Voidheart88/ELS-linreg/Ausarbeitung/els-ausarbeitung.tex

\input{preambel}
\input{environments}

\begin{document}
  \selectlanguage{ngerman}
  \input{kapitel/titelseite}
  \input{kapitel/abstract}
  \tableofcontents
  \input{kapitel/einfuehrung}     % Einleitung
  \input{kapitel/entwicklung}     % Entwicklung der Schaltung
  \input{kapitel/ergebnisse}      % Ergebnisse
  \newpage
  \addcontentsline{toc}{chapter}{Quellen}
  \bibliography{literatur}
  \addcontentsline{toc}{chapter}{Abbildungen}  
  \listoffigures
\end{document}
