Voidheart88/ELS-linreg/Ausarbeitung/preambel.tex

\documentclass[paper=A4,fontsize=12pt,headings=small,headsepline=true,footsepline=false,bibliography=totoc,DIV=7]{report}
\usepackage[utf8]{inputenc}
\usepackage[ngerman,english]{babel}
\usepackage{graphicx}
\usepackage{enumerate}
\usepackage{tabularx}
\usepackage{fancyhdr}
\usepackage{cite}
\usepackage{blindtext}
\usepackage[colorlinks,pdfpagelabels,pdfstartview = FitH,bookmarksopen = true,bookmarksnumbered = true,linkcolor = black,plainpages = false,hypertexnames = false,citecolor = black]{hyperref}
\usepackage{todonotes}
\usepackage{listings}
\usepackage{geometry}
\usepackage{wrapfig}
\usepackage{siunitx}
\usepackage{booktabs}

\clubpenalty=10000         % Keine "Schusterjungen"
\widowpenalty=10000        % Keine "Hurenkinder"
\displaywidowpenalty=10000 % Keine "Hurenkinder"
% Autor
\author{Dominik Stolte}
\title{\textbf{Seminararbeit \textendash{} Elektronische Schaltungen}}
\bibliographystyle{alphadin}
\geometry{left=3.0cm,right=2.5cm,top=2.5cm,bottom=2.5cm,includeheadfoot}
\setlength\abovecaptionskip{10pt}
