Voidheart88/ELS-linreg/Ausarbeitung/kapitel/titelseite.tex

\begin{titlepage}

  \par\vspace{1cm}
  \centering
	{\scshape\LARGE Hochschule Mannheim \par}
	\vspace{1cm}
	{\scshape\Large Seminararbeit ELS\par}
	\vspace{1.5cm}
	{\huge\bfseries Entwicklung eines rauscharmen diskreten linearreglers\par}
	\vspace{2cm}
	{\Large Erstellt von:\\
	Dominik Stolte, Mat. Nr.: 2150764, NM\\ 
	Dennis Henky Mat. Nr.: 2150765, NM\par}
	\vfill
	betreut durch\par
	Prof. \textsc{Koca}
	\vfill
	% Bottom of the page
	{\large \today\par}
\end{titlepage}
