Voidheart88/ELS-linreg/Ausarbeitung/kapitel/ergebnisse.tex

\chapter{Ergebnisse} 
Dieses Kapitel beschreibt die Ergebnisse der Arbeit.
Die bestückte Schaltung wird verschidenen Messungen unterzogen und diese 
ausgewertet.
Es wird auf Probleme bei der Inbetriebnahme hingewiesen und diese analysiert.
Zuletzt wird ein Fazit gezogen und auf zukünftige Möglichkeiten der Entwicklung
hingewiesen.

\section{Messungen}
Der folgende Abschnitt beschreibt die Messungen am Ausgang der fertigen 
Schaltung.
Es wurden verschiedene Messungen an der fertigen Schaltung durchgeführt.

\section{Probleme bei der Inbetriebnahme}
Bei der Inbetriebnahme wurde festgestellt, dass die Ausgangsspannung bei 
Einer Eingangsspannung über \num{19,4}\,\si{\volt} nicht mehr gehalten wird.
Dies entspricht nicht der Simulation. Auf die Gründe hierfür soll im folgenden
eingegangen werden.

\section{Fazit und Zukunft}
