Voidheart88/ELS-linreg/Ausarbeitung/kapitel/abstract.tex

\clearpage
\selectlanguage{ngerman}
\begin{abstract}
\noindent
Die Verfügbarkeit von Signalquellen mit hoher spektraler Reinheit ist für
die Entwicklung und der Bestimmung der Eigenschaften von 
Analog-Digital-Wandlern von besonderer Bedeutung.
Diese Arbeit beschreibt die Entwicklung, den Aufbau sowie den Test eines 
linearen Spannungsreglers zur Versorgung eines Wien-Robinson-Oszillators.
\end{abstract}
\selectlanguage{english}
\begin{abstract}
\noindent  
This could be your abstract.
\end{abstract}
\selectlanguage{ngerman}
