Voidheart88/ELS-linreg/common/messungen/in_vs_out.pdf

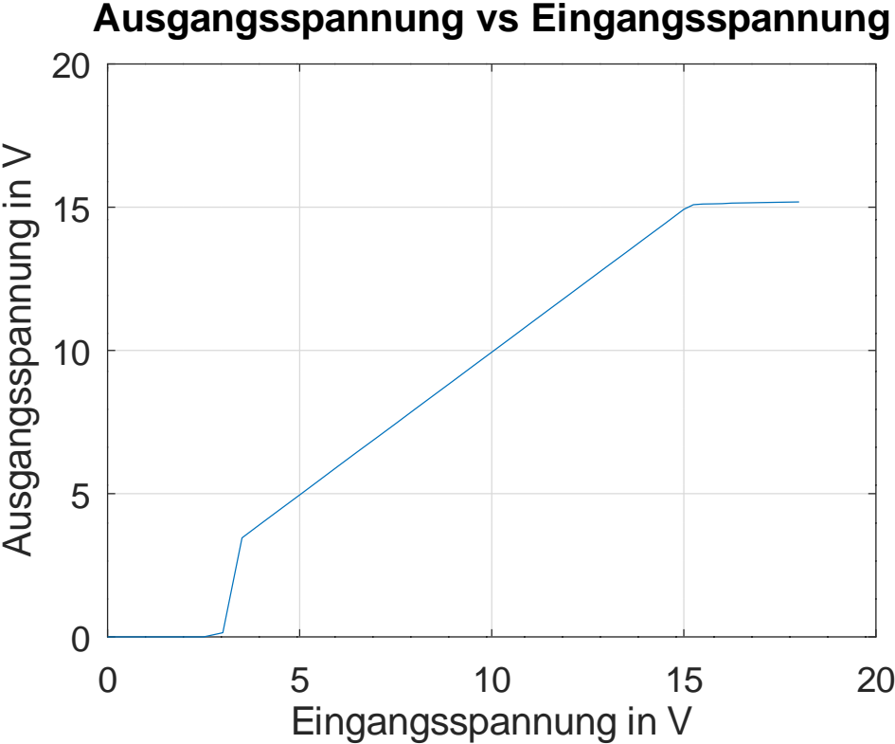
[picture p1: figure]
Eingangsspannung in V; Ausgangsspannung in V; Ausgangsspannung vs Eingangsspannung
