Voidheart88/ELS-linreg/common/Simulation/rauschen/haeufigkeit.pdf

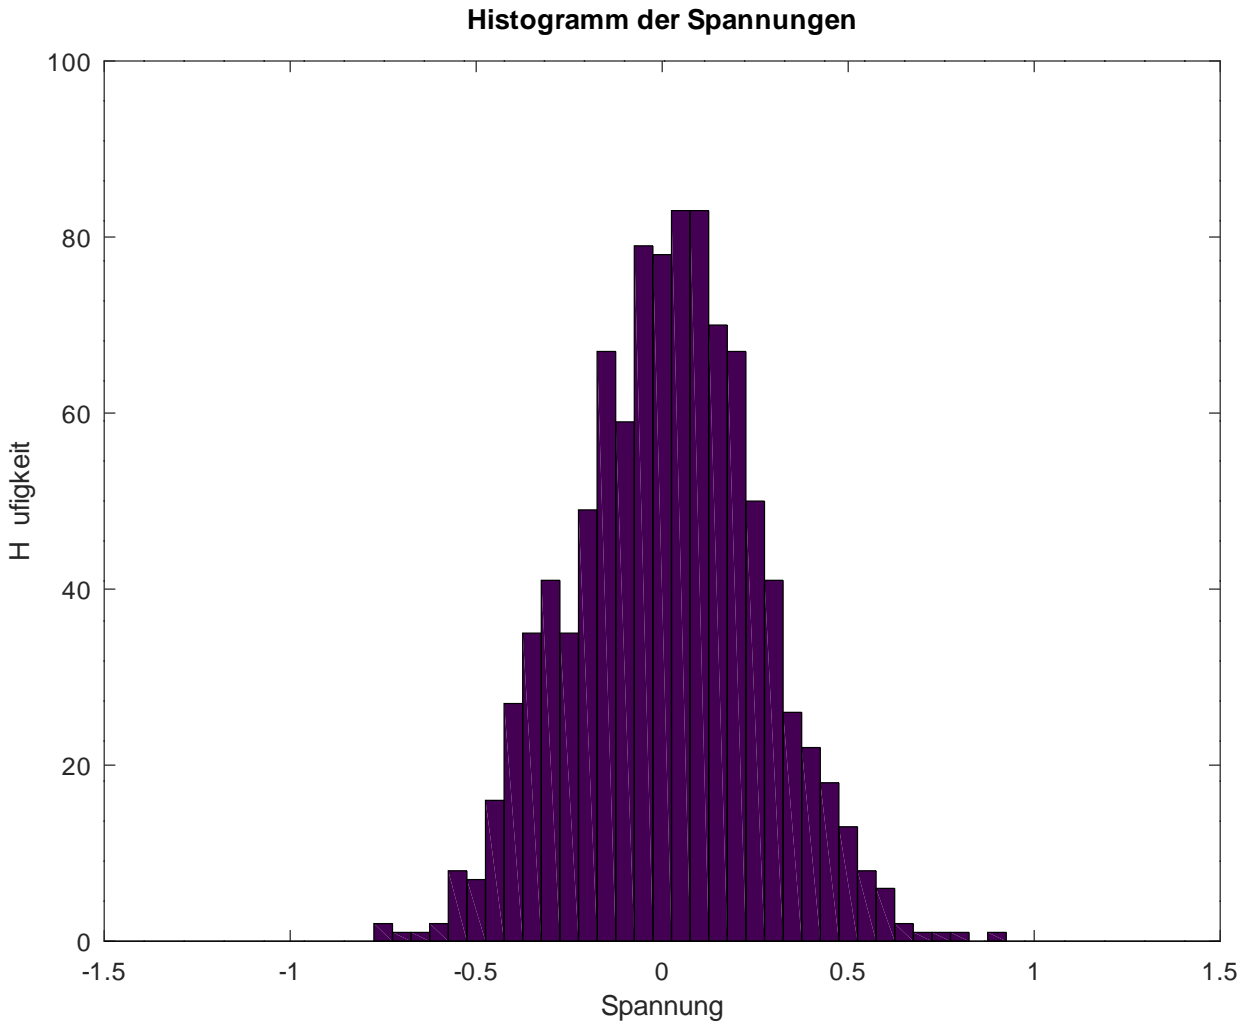
[picture p2: figure]
Histogramm der Spannungen; H ufigkeit; Spannung
