Voidheart88/ELS-linreg/common/Simulation/diagramme/0-25_R8.png

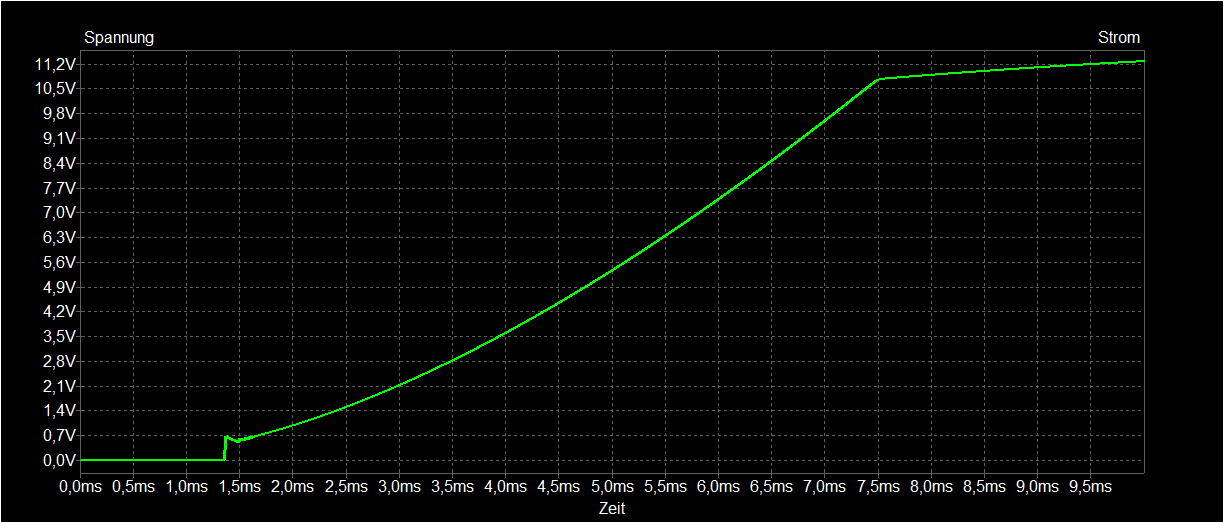
common/Simulation/diagramme/0-25_R8.png
