Voidheart88/ELS-linreg/common/Simulation/diagramme/10-25_eingangssignal.png

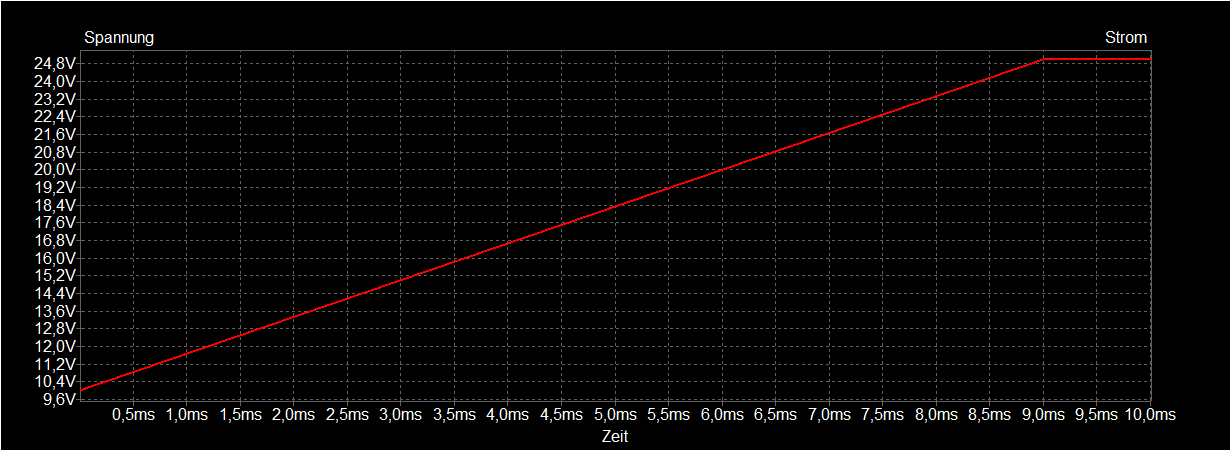
common/Simulation/diagramme/10-25_eingangssignal.png
