Voidheart88/ELS-linreg/common/Simulation/diagramme/10-25_eingangssignal_R8.png

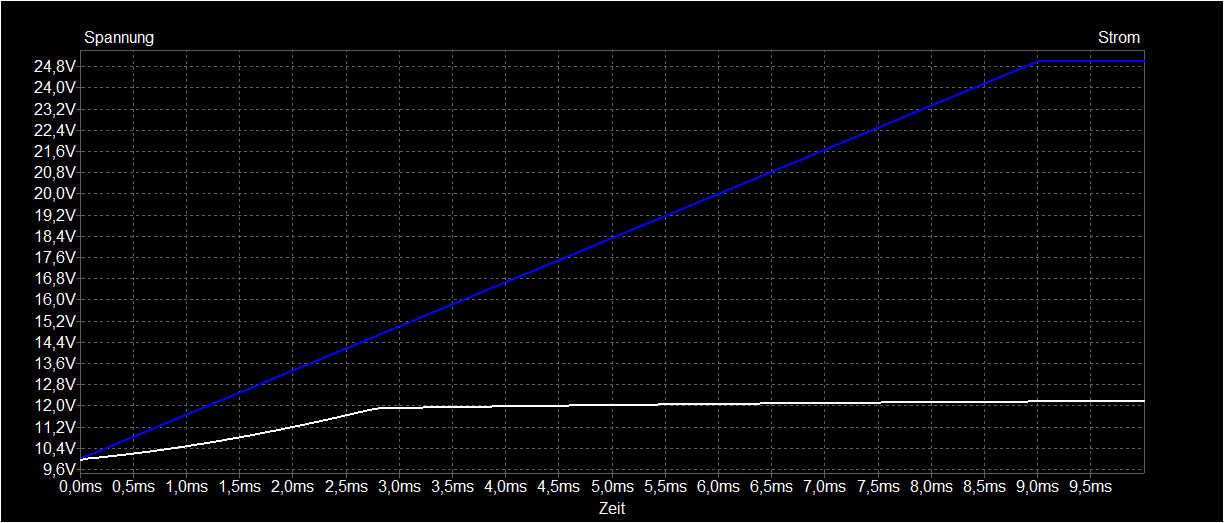
common/Simulation/diagramme/10-25_eingangssignal_R8.png
