Voidheart88/ELS-linreg/common/Simulation/out.pdf

5k 15V

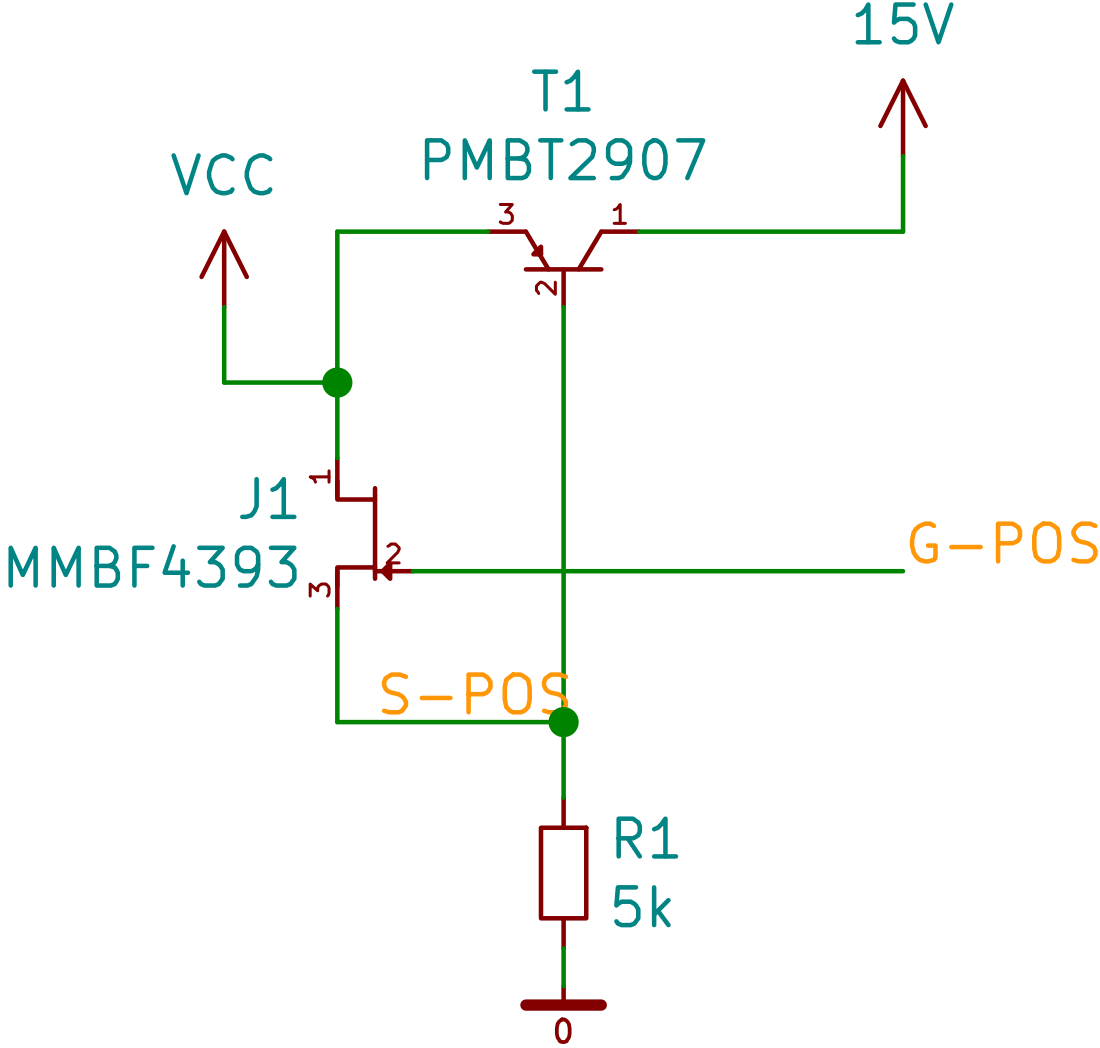
[picture p7: page 1]
VCC; 3 J1 MMBF4393; 3 T1 PMBT2907 S-POS; G-POS
