Voidheart88/ELS-linreg/common/Simulation/diffamp.pdf

# 5k VCC

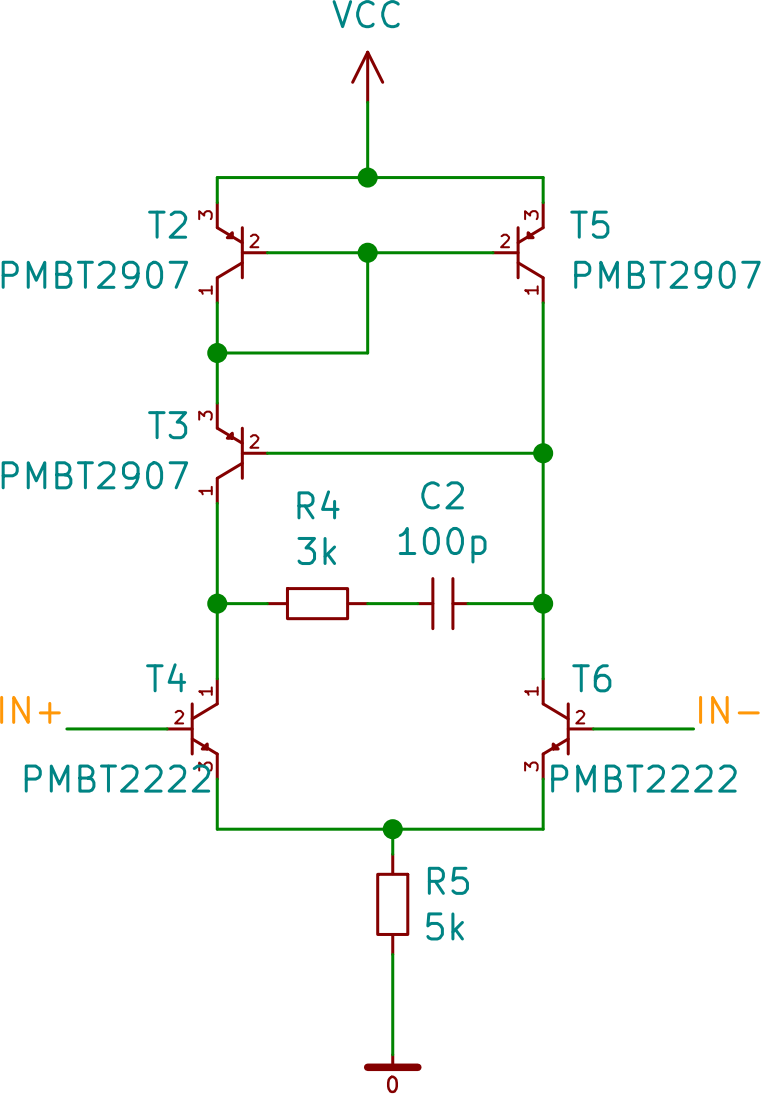
[picture p8: page 1]
3 T4 PMBT2222 R5; 3 T2 PMBT2907 1 2; 3 T5PMBT2907; 3 T6 PMBT2222; 3 T3 PMBT2907
