Voidheart88/ELS-linreg/common/Simulation/feedbackteiler.pdf

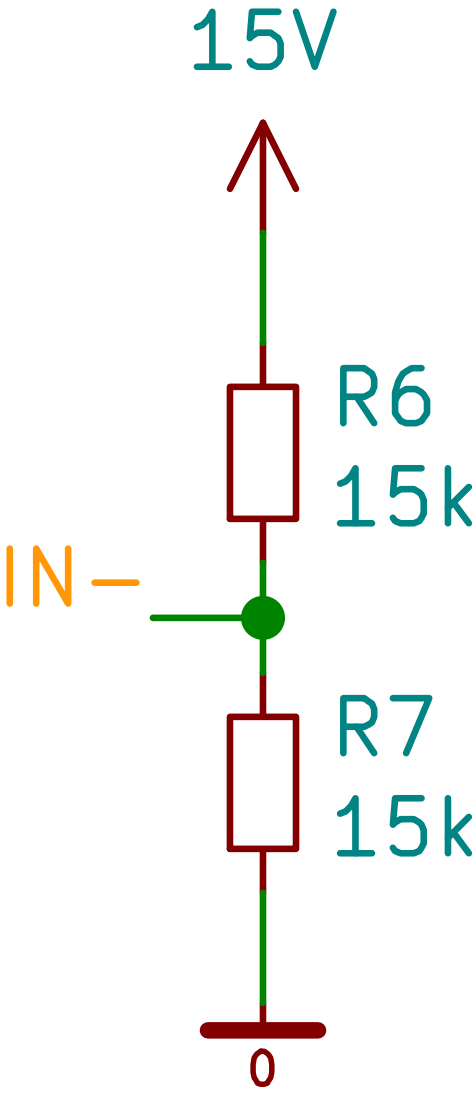
[picture p9: page 1]
