Voidheart88/ELS-linreg/common/Simulation/ref.pdf

# 1u VCC

1k R2

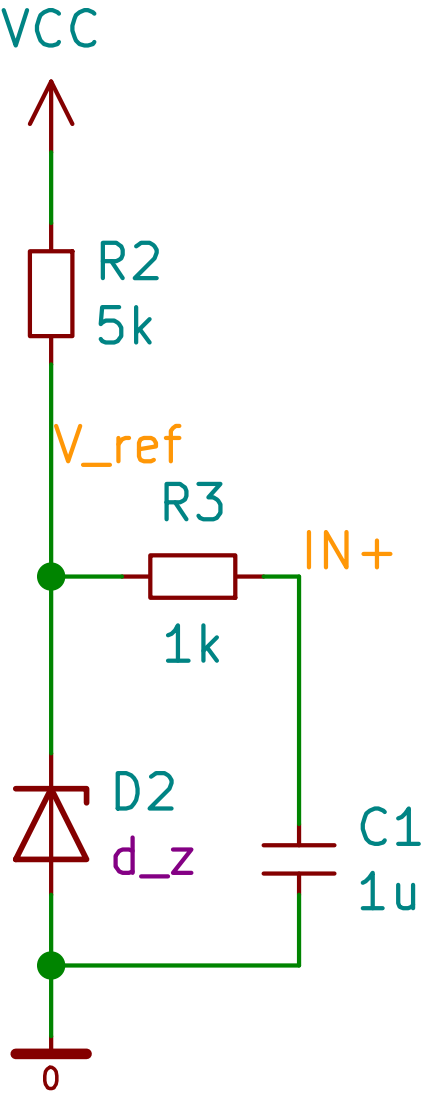
[picture p10: page 1]
5k V_ref
