Voidheart88/ELS-linreg/common/messungen/netzteilspannung.pdf

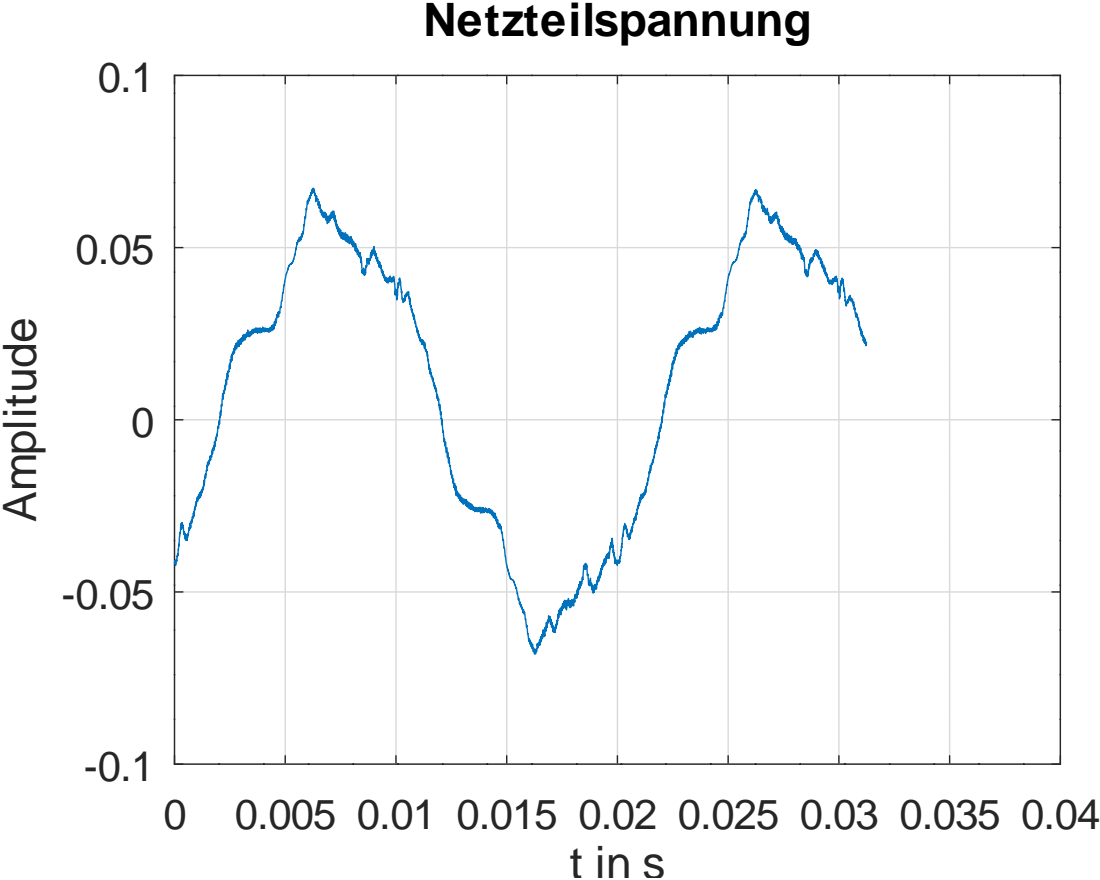
[picture p11: page 1]
Amplitude; Netzteilspannung
