Voidheart88/ELS-linreg/common/messungen/netzteilspektrum.pdf

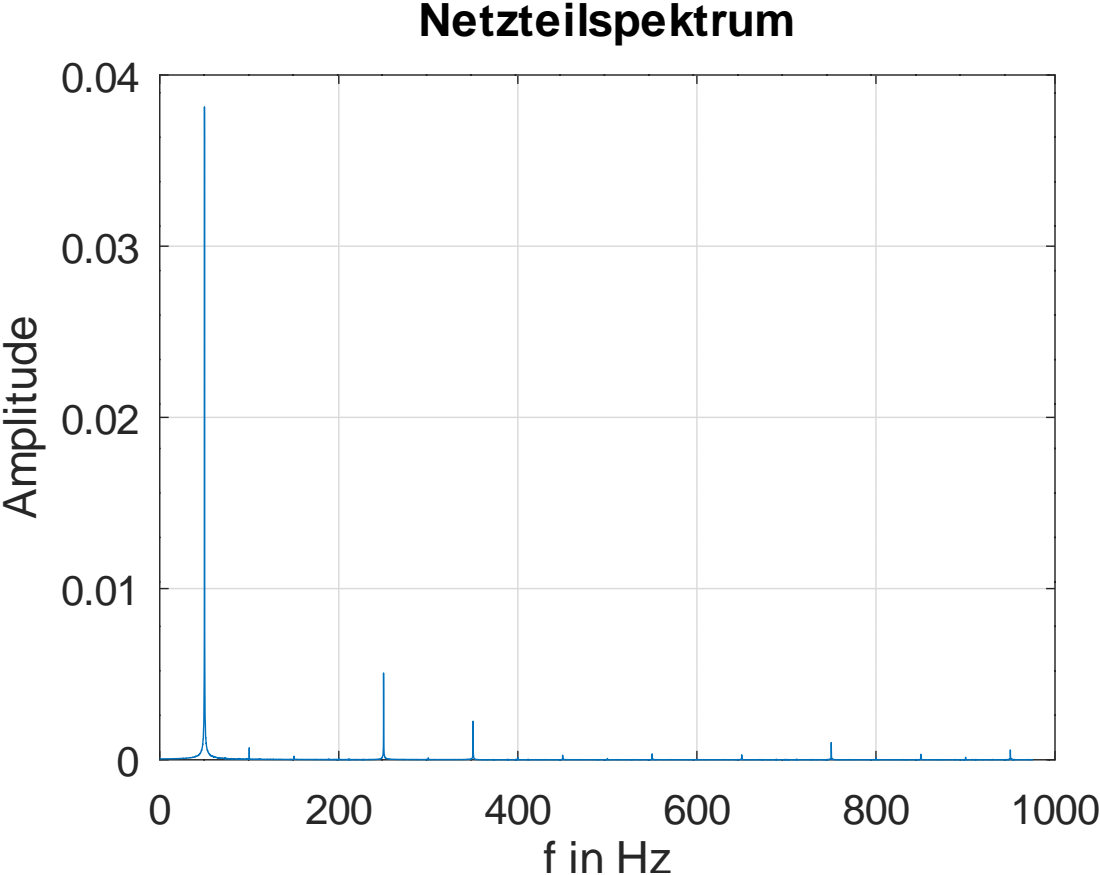
[picture p12: page 1]
Amplitude; Netzteilspektrum
