Voidheart88/ELS-linreg/common/messungen/regler-spg-batt.pdf

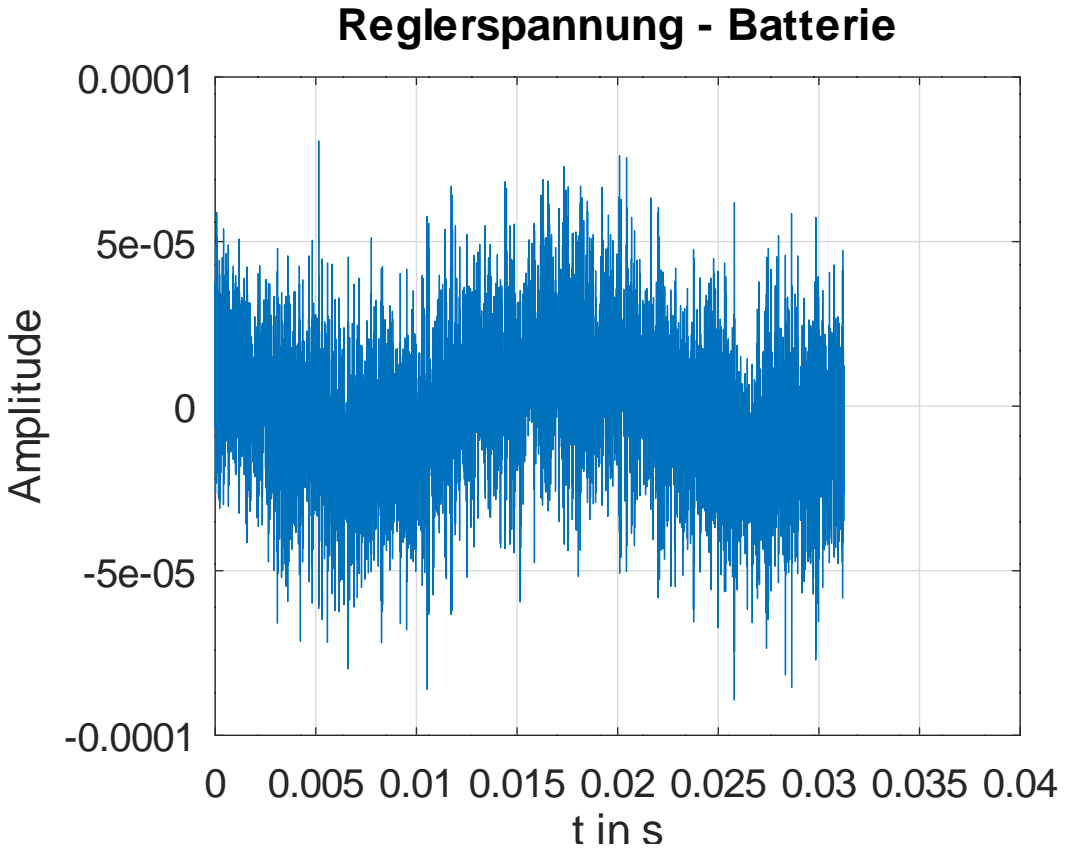
[picture p13: page 1]
Reglerspannung - Batterie; Amplitude
