Voidheart88/ELS-linreg/common/messungen/regler-spkt-batt.pdf

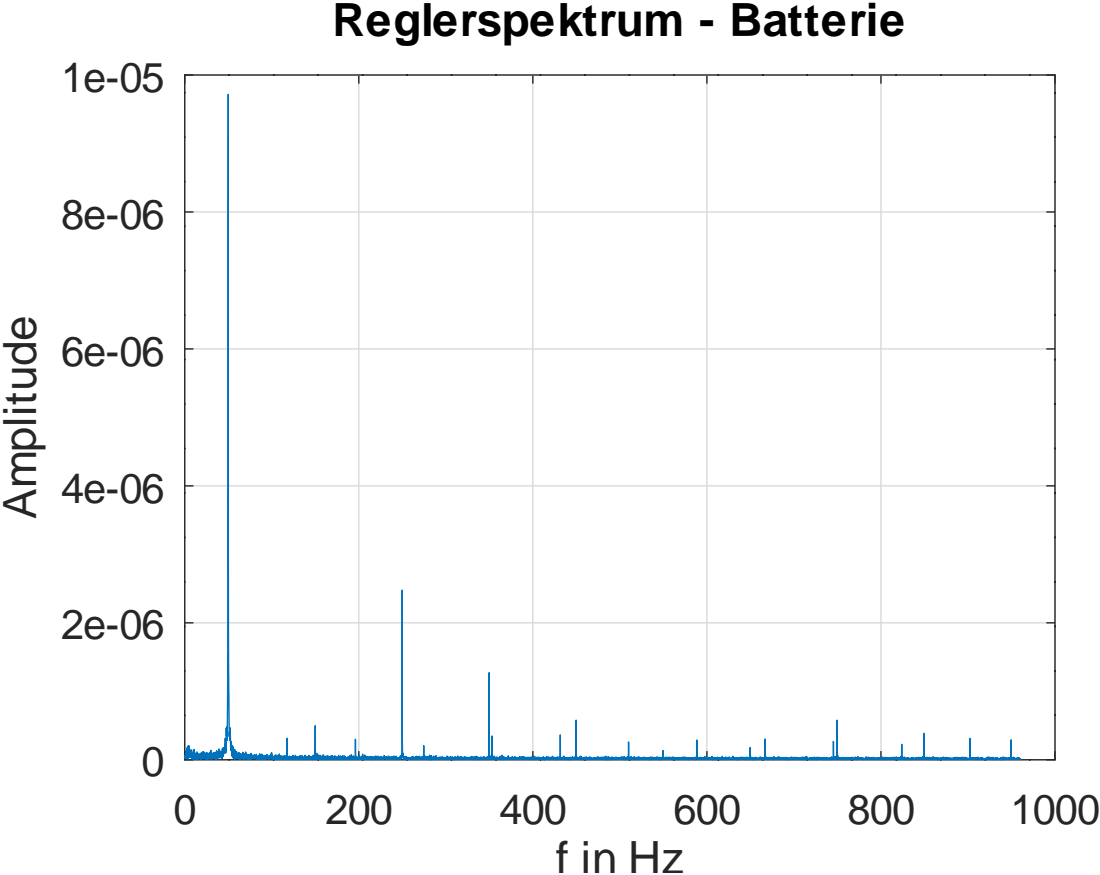
[picture p14: page 1]
Reglerspektrum - Batterie; Amplitude
