Voidheart88/ELS-linreg/common/messungen/reglerspannung.pdf

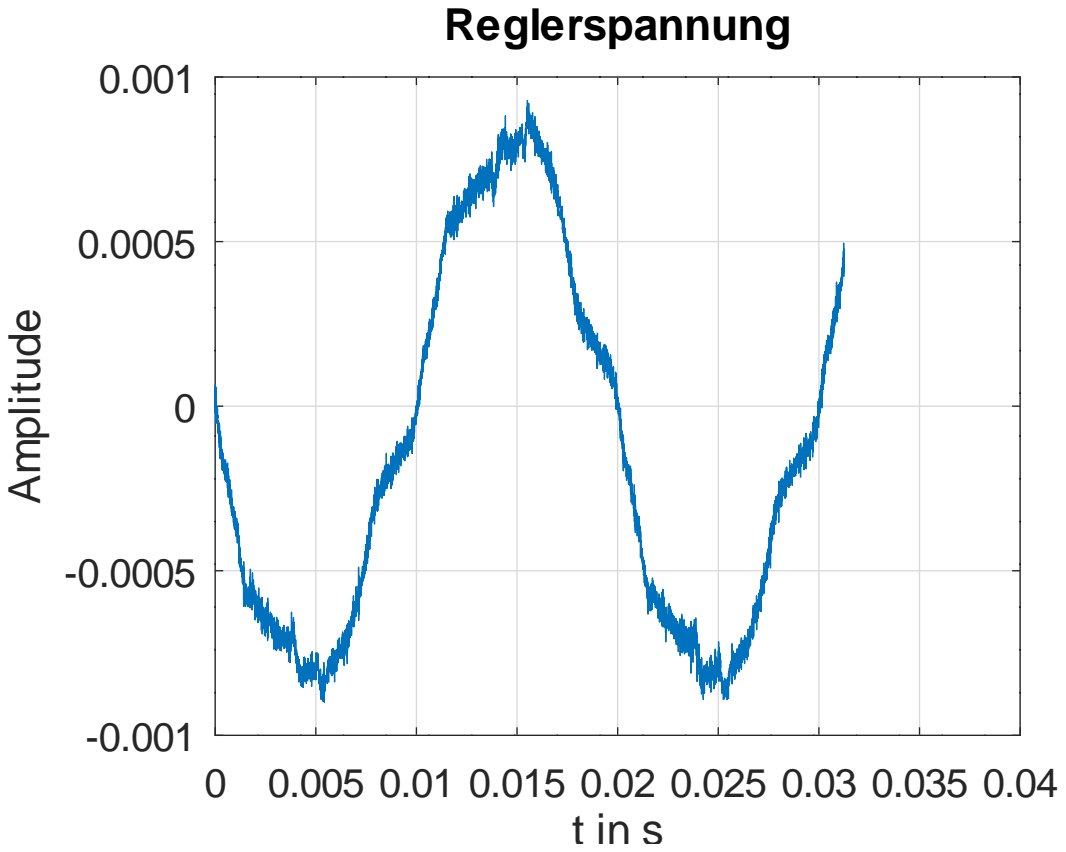
[picture p15: page 1]
Reglerspannung; Amplitude
