Voidheart88/ELS-linreg/common/messungen/reglerspektrum.pdf

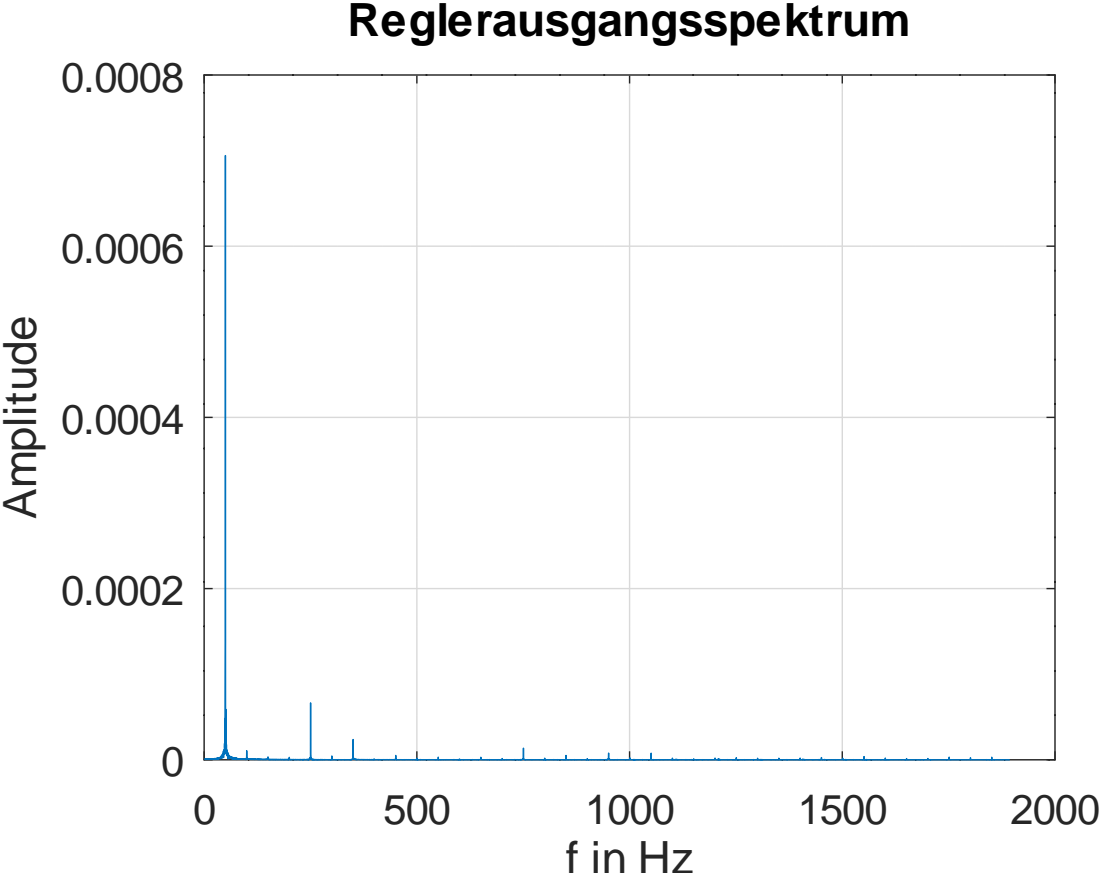
[picture p16: page 1]
Reglerausgangsspektrum; Amplitude
