Voidheart88/ELS-linreg/common/bilder/pcb-wien.pdf

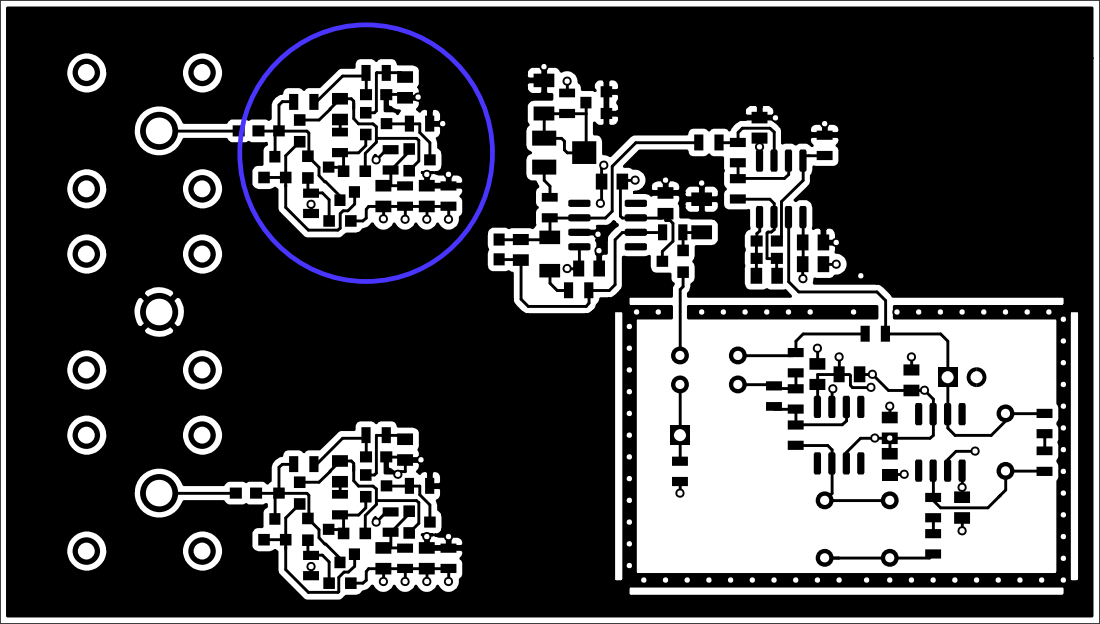
[picture p17: page 1]
