Voidheart88/ELS-linreg/common/bilder/schrotrauschen.pdf

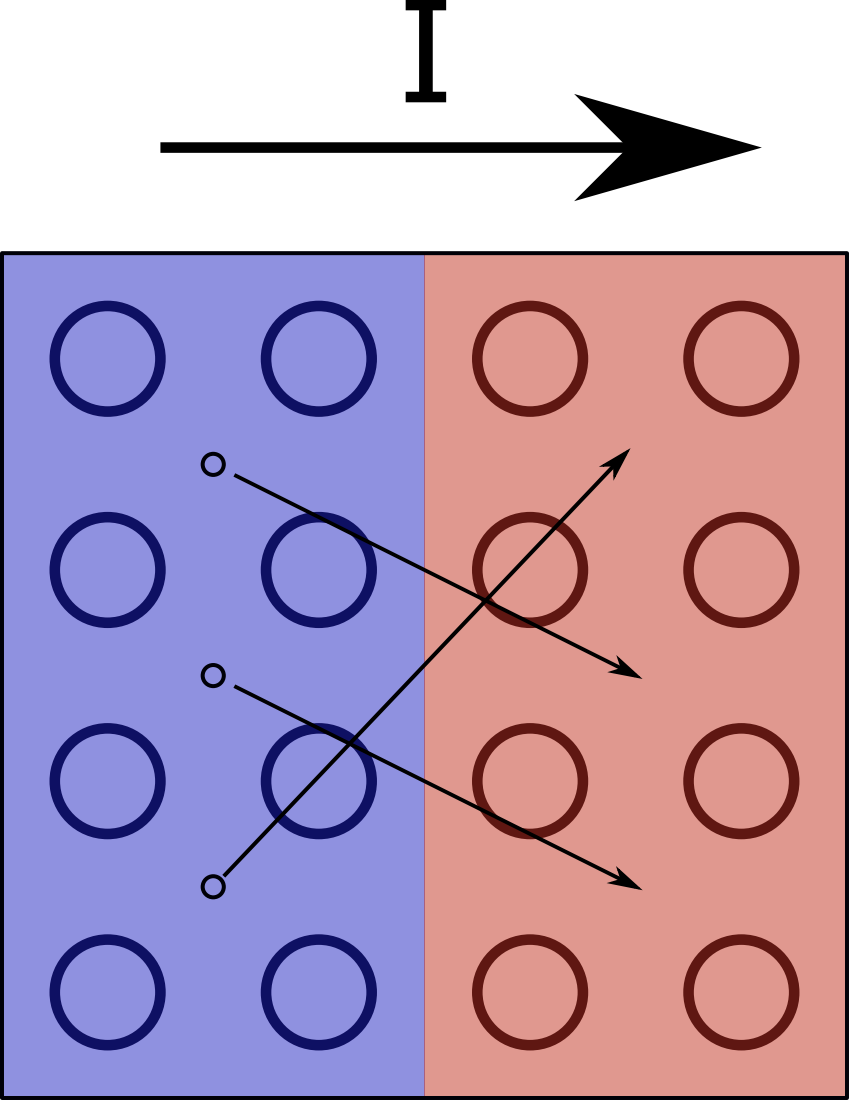
[picture p18: page 1]
