Voidheart88/ELS-linreg/common/schaltungen/reg.pdf

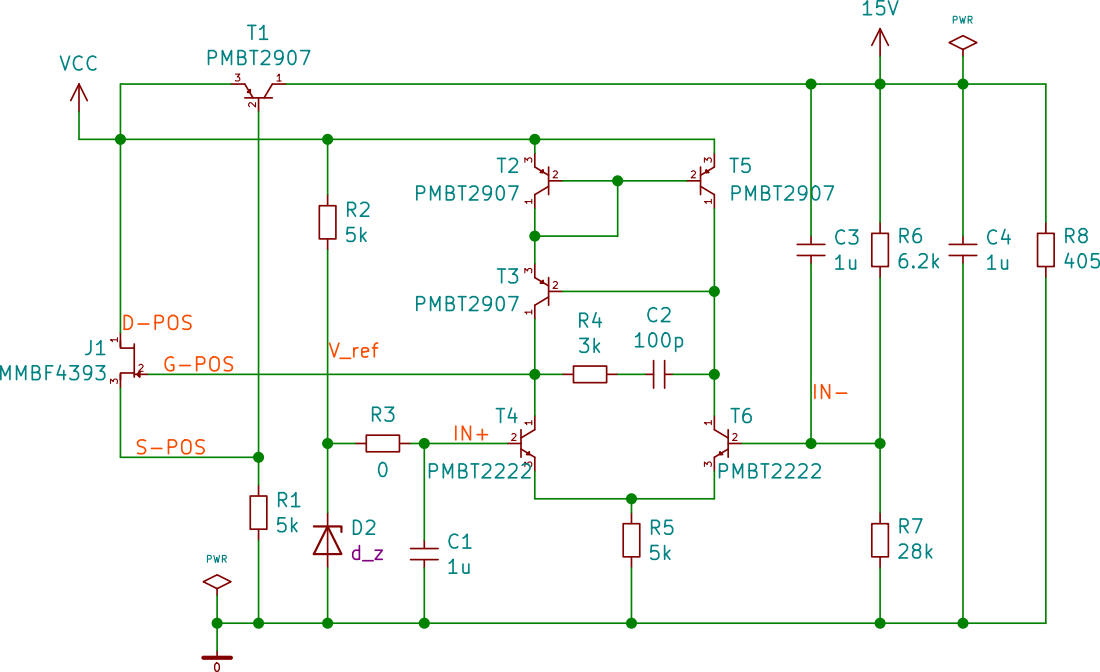
[picture p19: page 1]
