Voidheart88/ELS-linreg/common/schaltungen/last.pdf

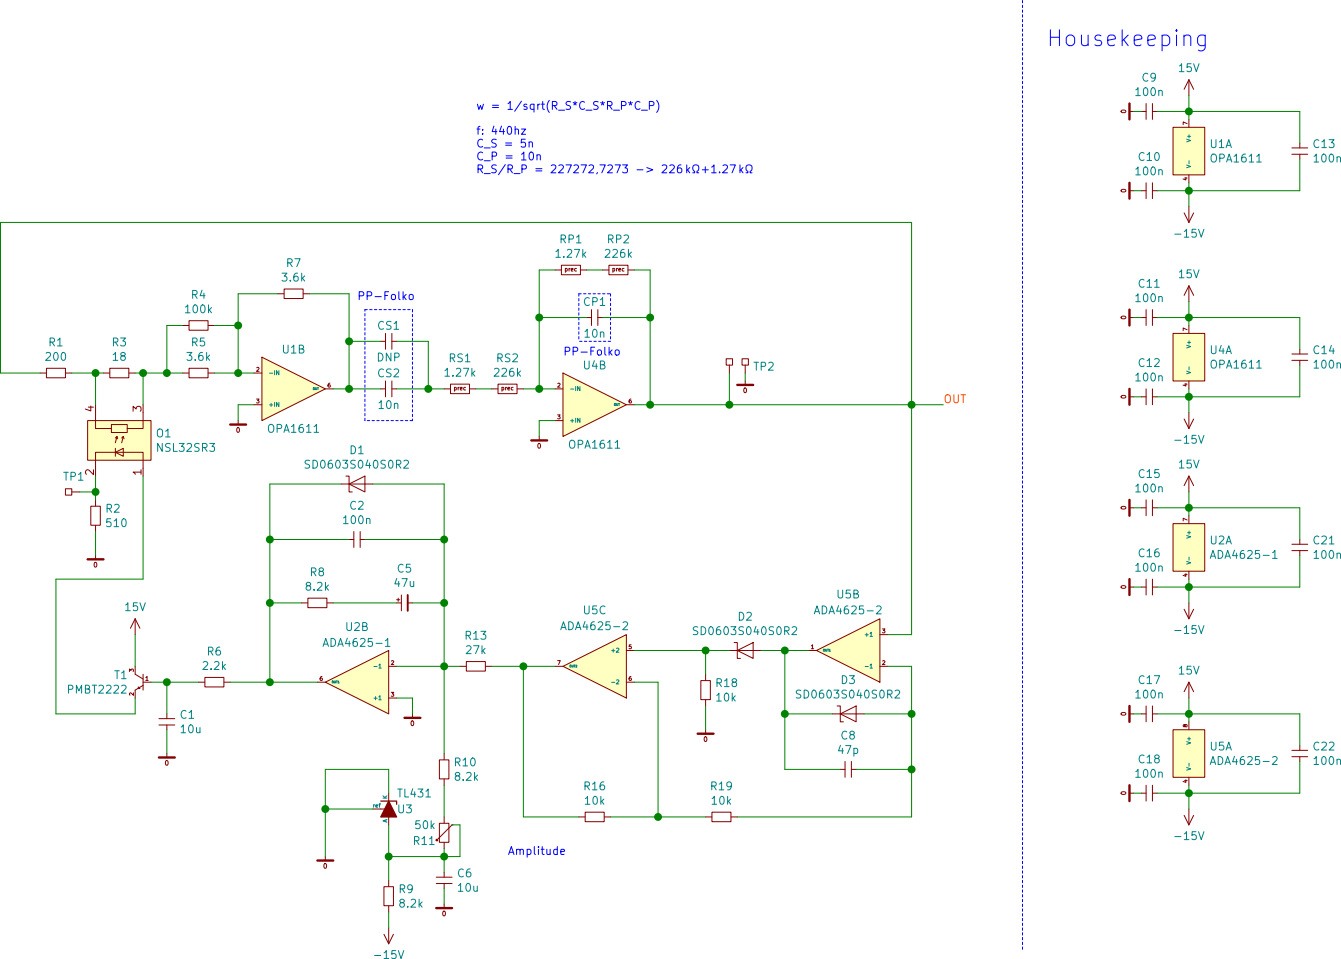
[picture p20: page 1]
