Voidheart88/ELS-linreg/common/Simulation/audioinput/pink-spkt.pdf

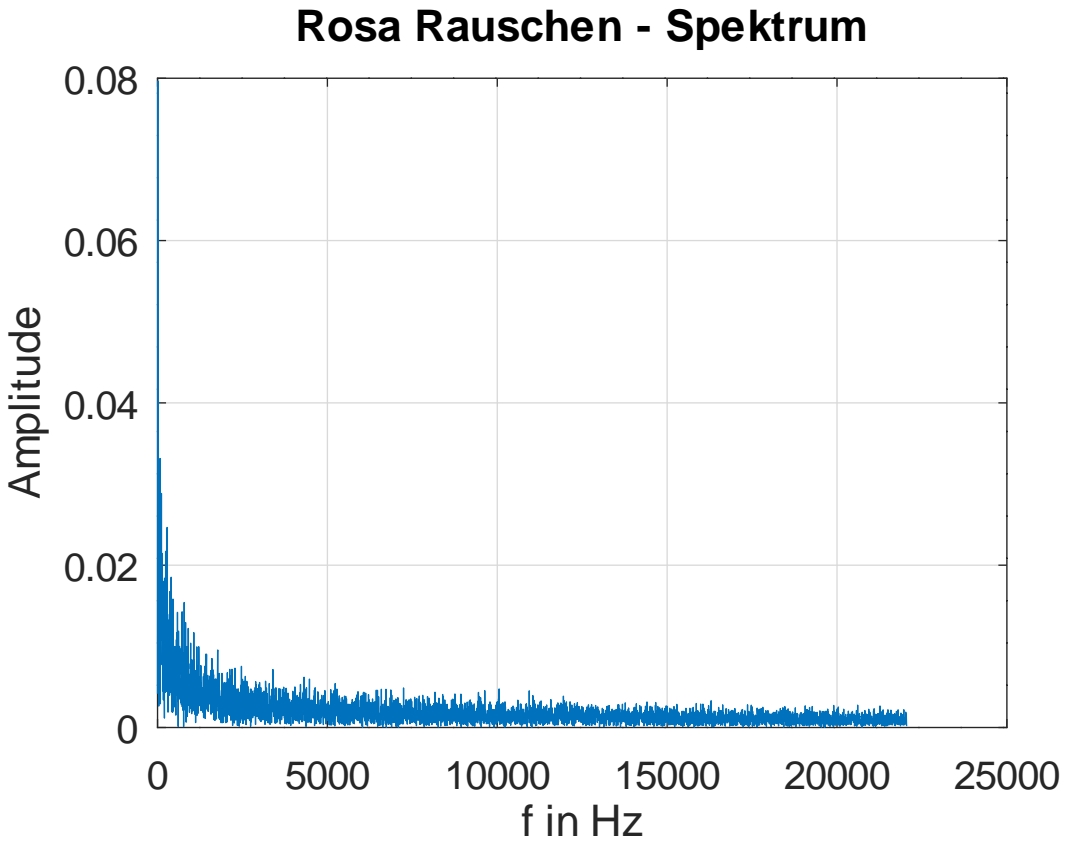
[picture p21: page 1]
Amplitude

Rosa Rauschen - Spektrum
