Voidheart88/ELS-linreg/common/Simulation/audioinput/pink-time.pdf

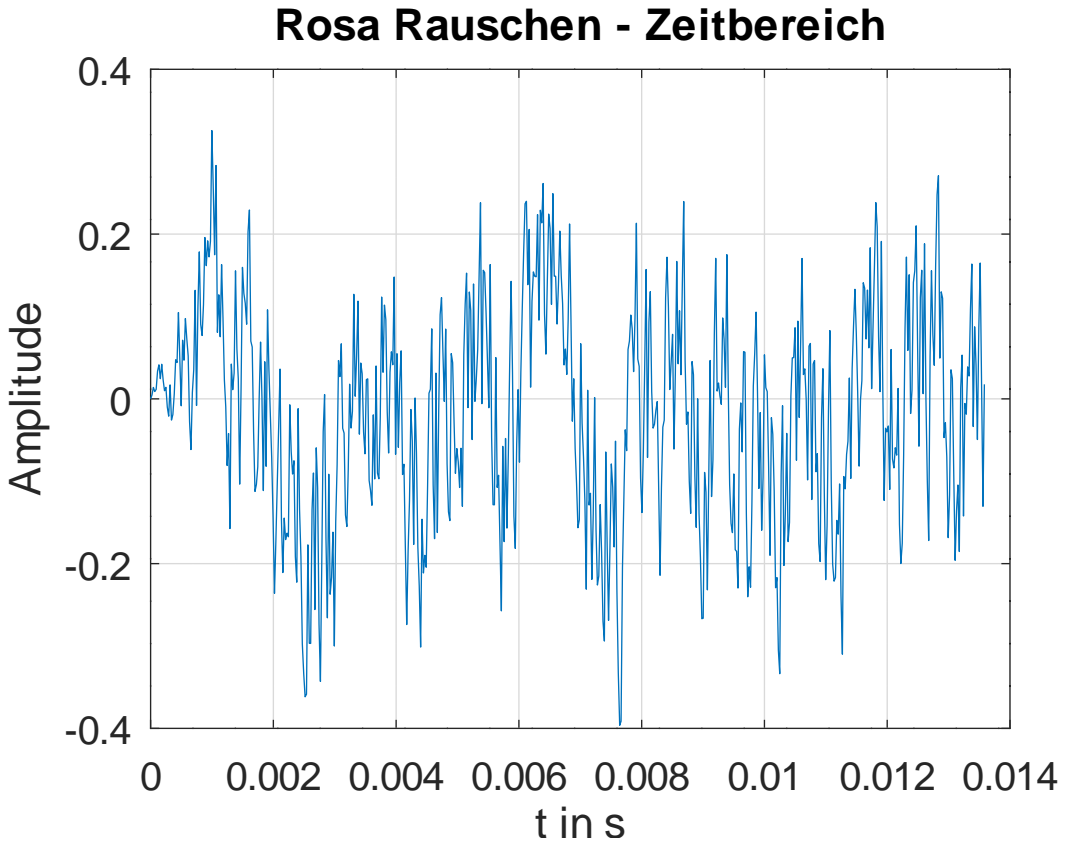
[picture p22: page 1]
Amplitude

Rosa Rauschen - Zeitbereich
