Voidheart88/ELS-linreg/common/Simulation/audioinput/white-spkt.pdf

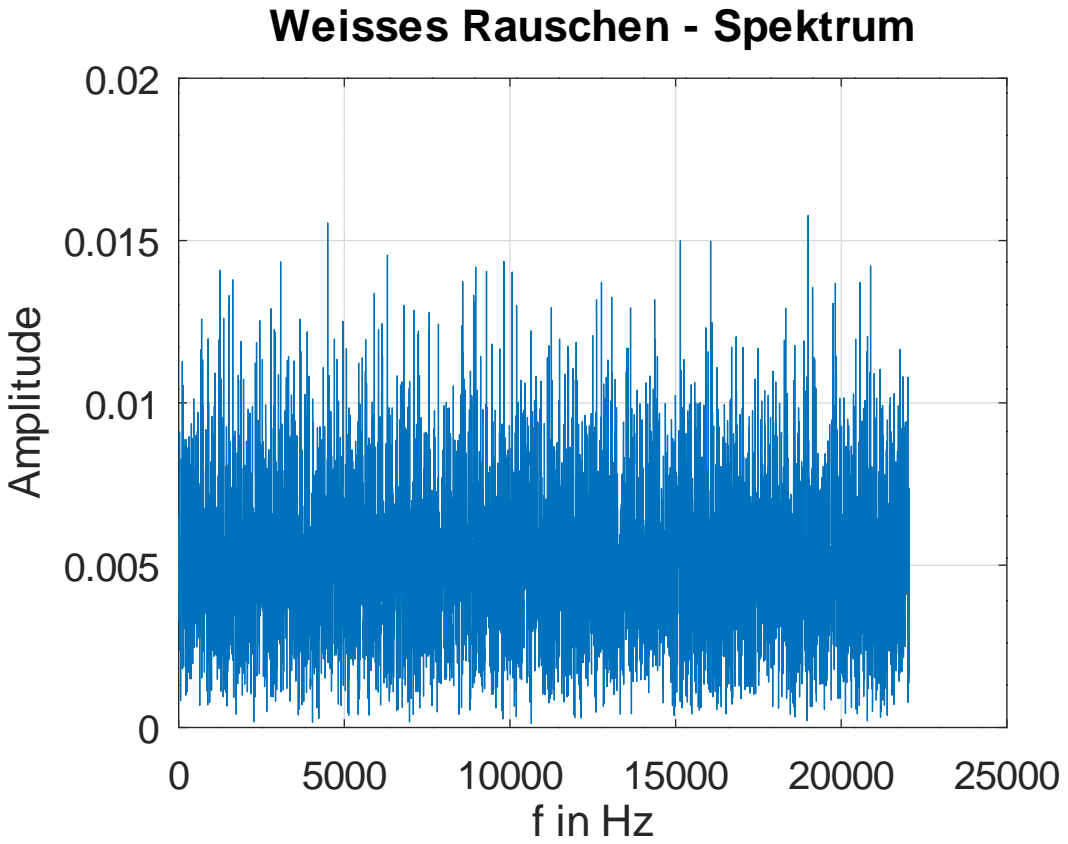
[picture p23: page 1]
Amplitude

Weisses Rauschen - Spektrum
