Voidheart88/ELS-linreg/common/Simulation/audioinput/white-time.pdf

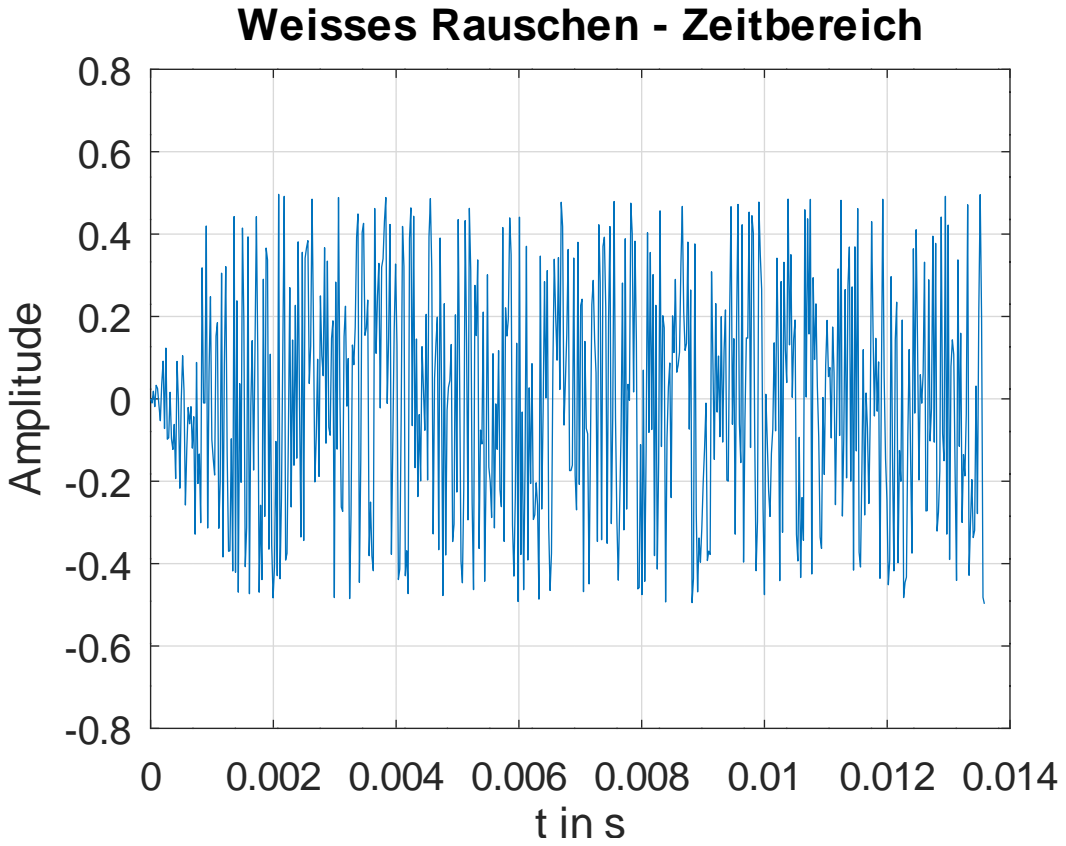
[picture p24: page 1]
Amplitude

Weisses Rauschen - Zeitbereich
