Voidheart88/ELS-linreg/common/schaltungen/widerstandsrauschen/widerstandsrauschen.pdf

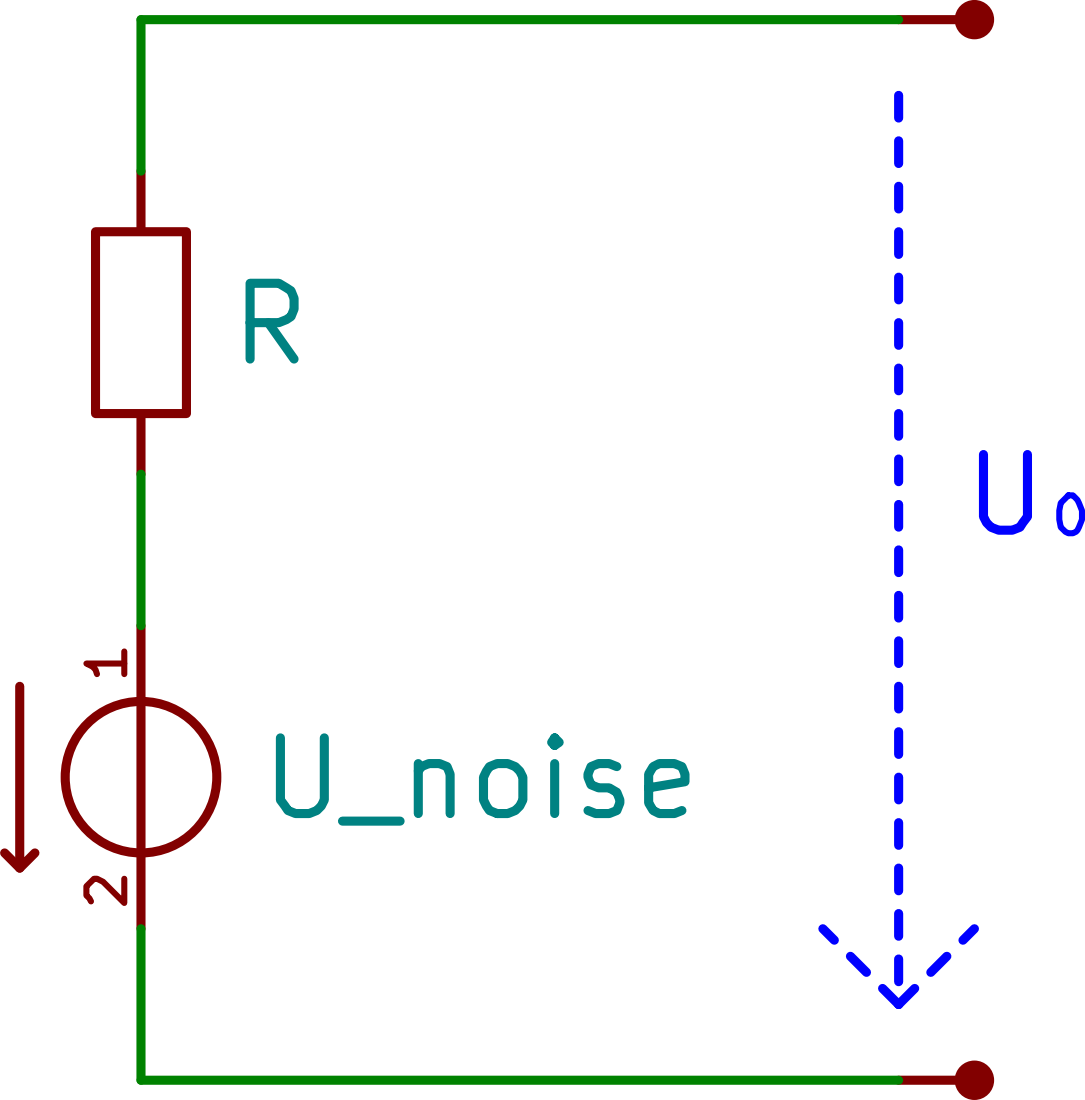
[picture p25: page 1]
