Voidheart88/ELS-linreg/common/Simulation/rauschen/spannung.pdf

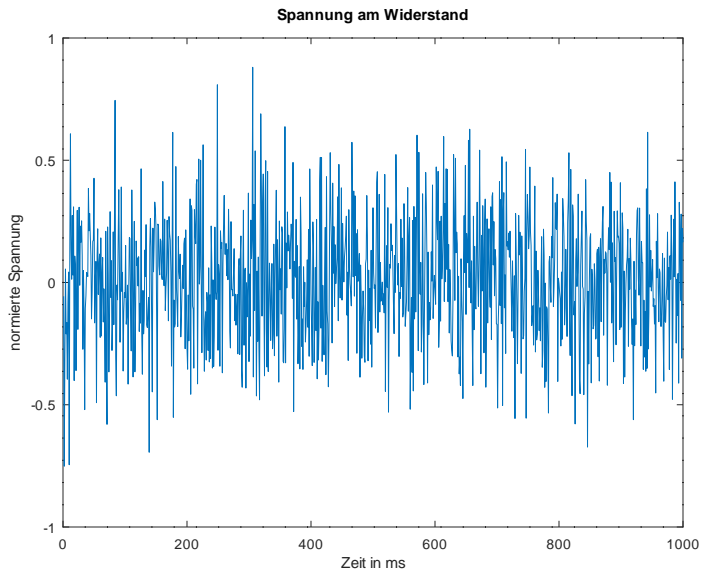
[picture p26: page 1]
normierte Spannung

Spannung am Widerstand

Zeit in ms
