Voidheart88/ELS-linreg/common/schaltungen/linearregler/linearregler.pdf

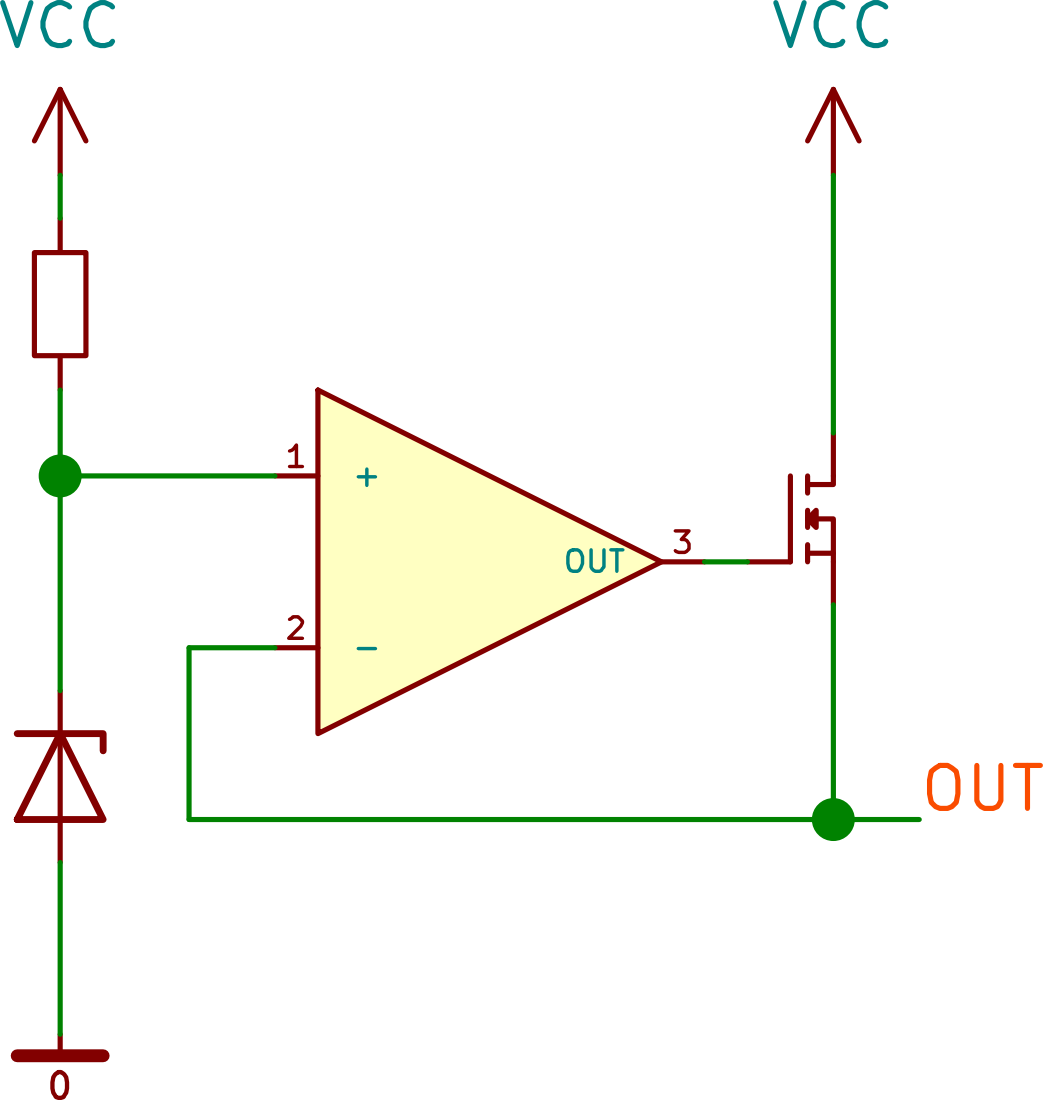
[picture p27: page 1]
