Voidheart88/ELS-linreg/common/Simulation/blockdiagramme/blockdiagramme.kicad_pcb

## KiCad design m0 with NRF24L01 header.sch


Parts:
J1: 3V3_GND; PinHeader_1x02_P2.54mm_Vertical
J2: Taranis_Level_Shifted; PinHeader_1x04_P2.54mm_Vertical
J3: Conn_01x05_Female Taranis I/O; PinHeader_1x05_P2.54mm_Vertical
Q1, Q2: SI2304DDS-T1-GE3; SOT-23
R1, R2, R3, R4: 10k; R_0603_1608Metric

Connections:
+3.3V: J1.1, Q1.2 (G), Q2.2 (G), R1.1, R3.1
+BATT: J2.4, J3.3, R2.1, R4.1
GND: J1.2, J3.4
PWM_TC_INPUT: J2.1, Q1.3 (S), R1.2
Taranis_HEARTBEAT: J3.2, Q2.1 (D), R4.2
Taranis_HEARTBEAT_3V3: J2.2, Q2.3 (S), R3.2
Taranis_OUT: J3.1, Q1.1 (D), R2.2
Taranis_SPORT: J2.3, J3.5

Notes on the sheet:
Needs to go to timer input
To MCU (3.3V)
To MCU (+VBatt)
