Voidheart88/ELS-linreg/(commit log)

2021-03-31 add simulations
    [reg.sch, stellglied.sch]
2021-04-09 update Simulation
    [diffamp-test.sch, reg.sch]
2021-06-05 added lin reg
    [linearregler.sch]
2021-06-07 add Noise
    [widerstandsrauschen.kicad_pcb, widerstandsrauschen.sch]
2021-06-08 update noise simulation
    [linearregler.sch, reg.sch, widerstandsrauschen.kicad_pcb, widerstandsrauschen.sch]
2021-07-19 finished presentation
    [vin_vs_vout.csv, vin_vs_vout_old.csv]
2021-07-19 added plots
    [diffamp.sch, feedbackteiler.sch, out.sch, ref.sch, reg.sch]
2021-07-20 Regelkreis hinzugefuegt
    [0-25_R8.csv, 10-25_R8.csv, 10-25_eingangssignal.csv, 10-25_eingangssignal_R8.csv, blockdiagramme.kicad_pcb, blockdiagramme.sch]
